doxuanhieu185/dohieu-khoaluan-uet/README.md

# dohieu-khoaluan-uet
# Graduation Thesis

The graduation thesis is titled: "Design of a Voice-Controlled Smart Switch with IoT Integration". This is an AIoT system, a combination of AI and IoT. It collects, classifies, and recognizes voice commands to control devices through the Seeed Studio Xiao nRF52840 Sense and ESP32 Devkit V1 microcontrollers. The mobile application is developed based on the React Native framework, and it can operate on both iOS and Android.

The voice recognition training model is implemented using machine learning techniques, leveraging familiar libraries such as TensorFlow.
Mobile app source code is on Master branch
# Slide [here](https://docs.google.com/presentation/d/1uaaRseHWvzrKwHW-IcVz3Z_7Hlt_9U-M/edit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)

UET
