doxuanhieu185/dohieu-khoaluan-uet/deployment-file/README.md

You can add arduino library to Arduino IDE. Add zip this file.
